cliffanet/sigplane/cable.md

# Ан-28

* Голова-распредблок (5 жил): 230-250 см
* Левый борт (4 жил): 310-330 см
* Правый борт (4 жил): 200-220 см
