cliffanet/sigplane/hw/head/v0.1/sigplane-ctrl-v0.1.png

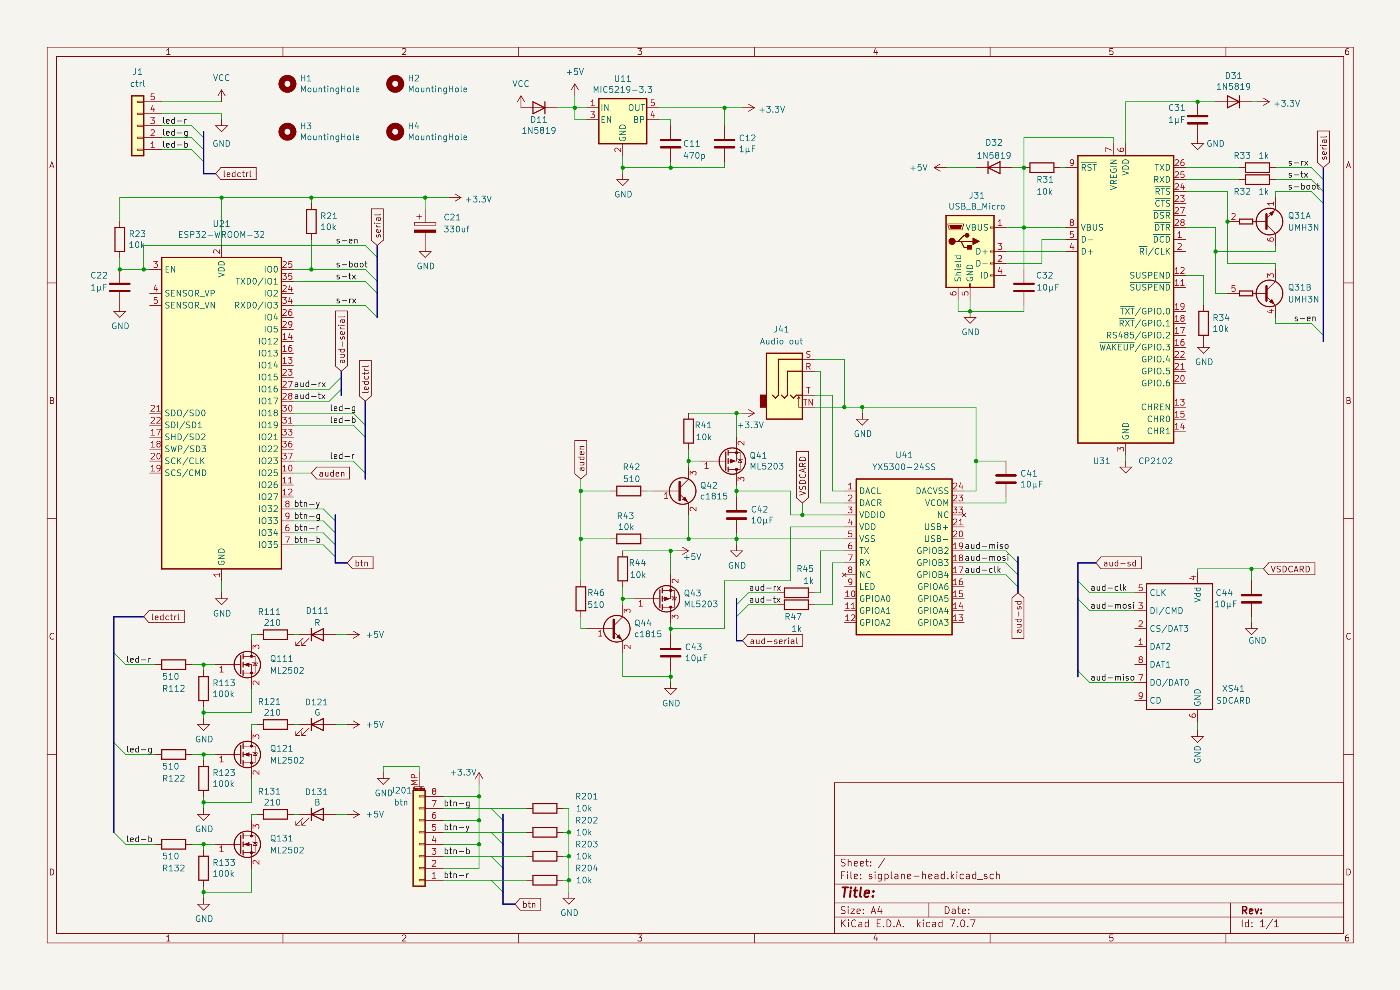
hw/head/v0.1/sigplane-ctrl-v0.1.png
