cliffanet/sigplane/hw/power/v0.1/sigplane-power-v0.1.png

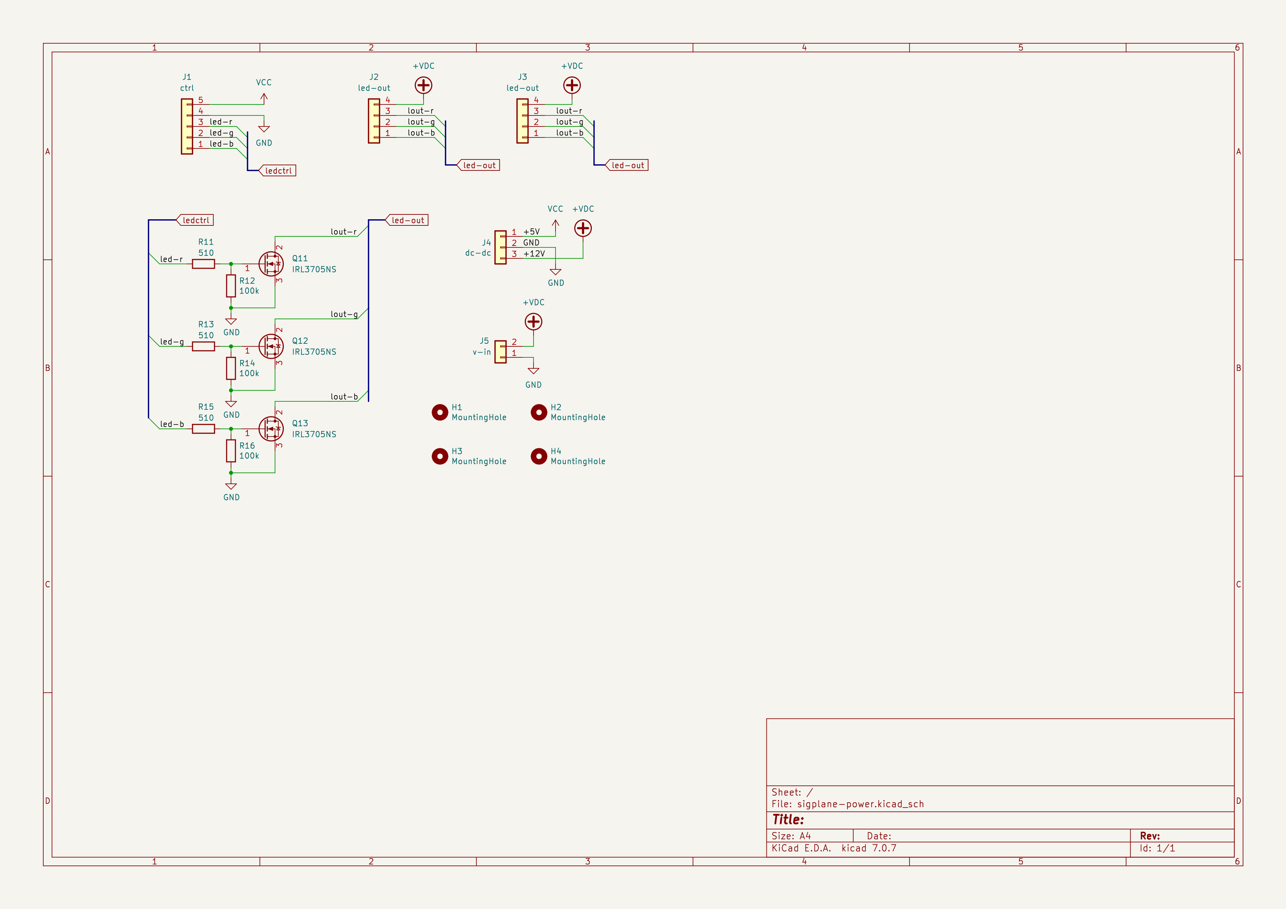
hw/power/v0.1/sigplane-power-v0.1.png
