cliffanet/sigplane/hw/head/sigplane-head.csv

Reference | Qty | Value | DNP | Exclude from BOM | Exclude from Board | Footprint | Datasheet
C11 | 1 | 470p |  |  |  | Capacitor_SMD:C_0805_2012Metric | ~
C12,C22,C31 | 3 | 1μF |  |  |  | Capacitor_SMD:C_0805_2012Metric | ~
C21 | 1 | 330uf |  |  |  | Capacitor_Tantalum_SMD:CP_EIA-7343-20_Kemet-V | ~
C32,C41,C42,C43,C44 | 5 | 10μF |  |  |  | Capacitor_SMD:C_0805_2012Metric | ~
D11,D31,D32 | 3 | 1N5819 |  |  |  | Diode_SMD:D_SOD-323 | ~
D111 | 1 | R |  |  |  | LED_THT:LED_D10.0mm | ~
D121 | 1 | G |  |  |  | LED_THT:LED_D10.0mm | ~
D131 | 1 | B |  |  |  | LED_THT:LED_D10.0mm | ~
H1,H2,H3,H4 | 4 | MountingHole |  |  |  | MountingHole:MountingHole_3.2mm_M3 | ~
J1 | 1 | ctrl |  |  |  | Connector_JST:JST_XH_S5B-XH-A_1x05_P2.50mm_Horizontal | ~
J31 | 1 | USB_B_Micro |  |  |  | Connector_USB:USB_Micro-B_Molex-105017-0001 | ~
J41 | 1 | Audio out |  |  |  | PJ-320B:BOOMELE_PJ-320B | ~
J201 | 1 | btn |  |  |  | Connector_Molex:Molex_PicoBlade_53398-0871_1x08-1MP_P1.25mm_Vertical | ~
Q31 | 1 | UMH3N |  |  |  | Package_TO_SOT_SMD:SOT-363_SC-70-6 | http://rohmfs.rohm.com/en/products/databook/datasheet/discrete/transistor/digital/emh3t2r-e.pdf
Q41,Q43 | 2 | ML5203 |  |  |  | Package_TO_SOT_SMD:SOT-23 | ~
Q42,Q44 | 2 | c1815 |  |  |  | Package_TO_SOT_SMD:SOT-23 | ~
Q111,Q121,Q131 | 3 | ML2502 |  |  |  | Package_TO_SOT_SMD:SOT-23 | ~
R21,R23,R31,R34,R41,R43,R44,R201,R202,R203,R204 | 11 | 10k |  |  |  | Resistor_SMD:R_0805_2012Metric | ~
R32,R33,R45,R47 | 4 | 1k |  |  |  | Resistor_SMD:R_0805_2012Metric | ~
R42,R46,R112,R122,R132 | 5 | 510 |  |  |  | Resistor_SMD:R_0805_2012Metric | ~
R111,R121,R131 | 3 | 210 |  |  |  | Resistor_SMD:R_1206_3216Metric | ~
R113,R123,R133 | 3 | 100k |  |  |  | Resistor_SMD:R_0805_2012Metric | ~
U11 | 1 | MIC5219-3.3 |  |  |  | Package_TO_SOT_SMD:SOT-23-5 | http://ww1.microchip.com/downloads/en/DeviceDoc/MIC5219-500mA-Peak-Output-LDO-Regulator-DS20006021A.pdf
U21 | 1 | ESP32-WROOM-32 |  |  |  | RF_Module:ESP32-WROOM-32 | https://www.espressif.com/sites/default/files/documentation/esp32-wroom-32_datasheet_en.pdf
U31 | 1 | CP2102 |  |  |  | Package_DFN_QFN:QFN-28-1EP_5x5mm_P0.5mm_EP3.35x3.35mm | https://www.silabs.com/documents/public/data-sheets/cp2102n-datasheet.pdf
U41 | 1 | YX5300-24SS |  |  |  | Package_SO:SSOP-24_3.9x8.7mm_P0.635mm | http://www.x-powers.com/en.php/Info/product_detail/article_id/95
XS41 | 1 | SDCARD |  |  |  | microsd:Conn_uSDcard | _
