cliffanet/sigplane/box/sigplane-power.FCStd

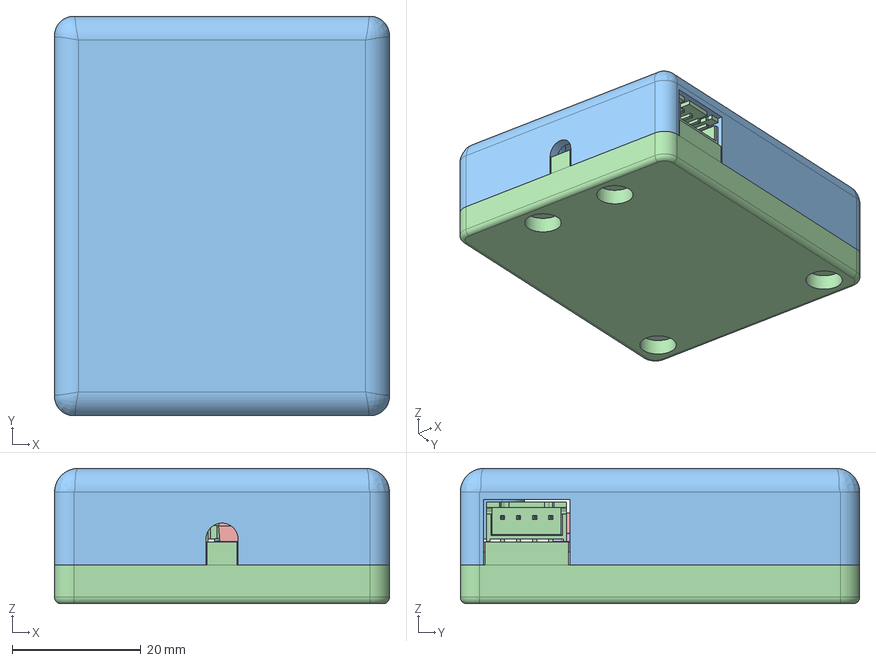
[picture p3: CAD file, 2026-11-03]
box/sigplane-power.FCStd
52.0 x 62.0 x 21.0 mm
sigplane-power PCB
top
bottom
