cliffanet/sigplane/box/sigplane-power-top.stl

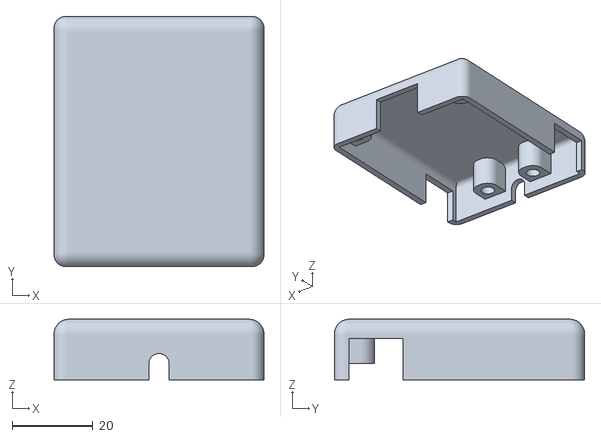
[picture p4: CAD file, 2026-11-03]
box/sigplane-power-top.stl
52.0 x 62.0 x 15.0
