cliffanet/sigplane/box/sigplane-head.FCStd

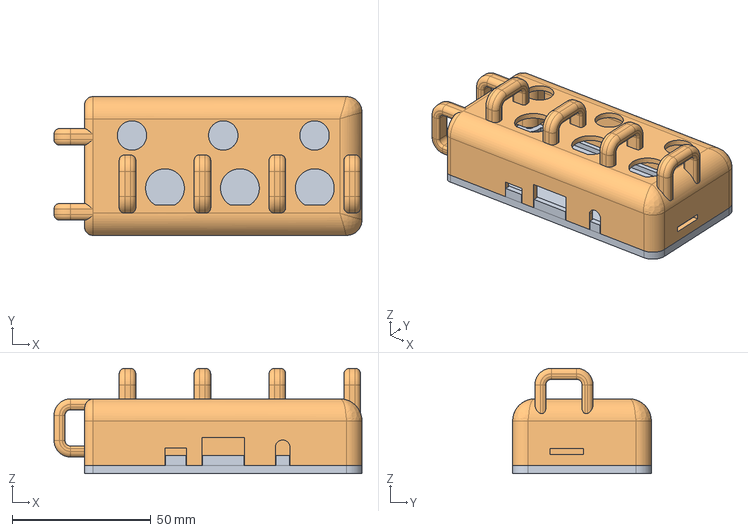
[picture p5: CAD file, 2026-11-03]
box/sigplane-head.FCStd
111.0 x 50.0 x 38.0 mm
bottom
