cliffanet/sigplane/box/sigplane-head-bottom.stl

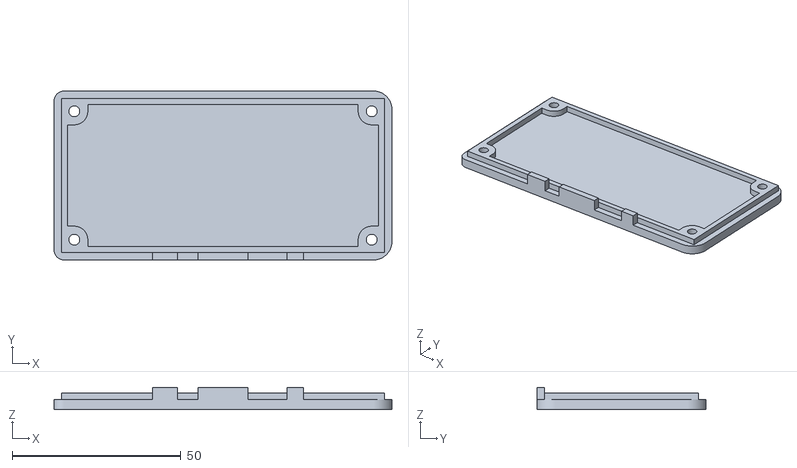
[picture p6: CAD file, 2026-11-03]
box/sigplane-head-bottom.stl
100.0 x 50.0 x 6.60
