cliffanet/sigplane/box/sigplane-head-top.stl

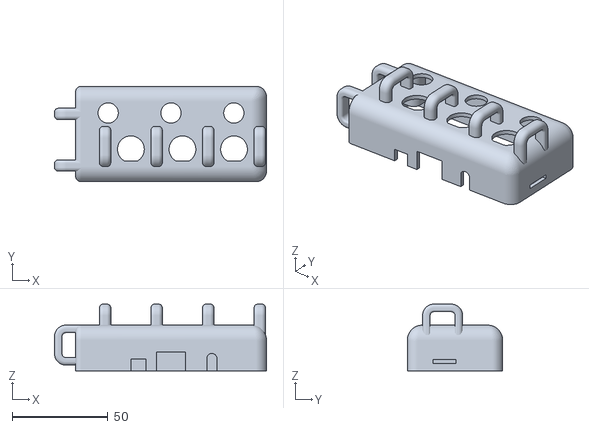
[picture p7: CAD file, 2026-11-03]
box/sigplane-head-top.stl
111.0 x 50.0 x 35.0
