cliffanet/sigplane/box/sigplane-power-bottom.stl

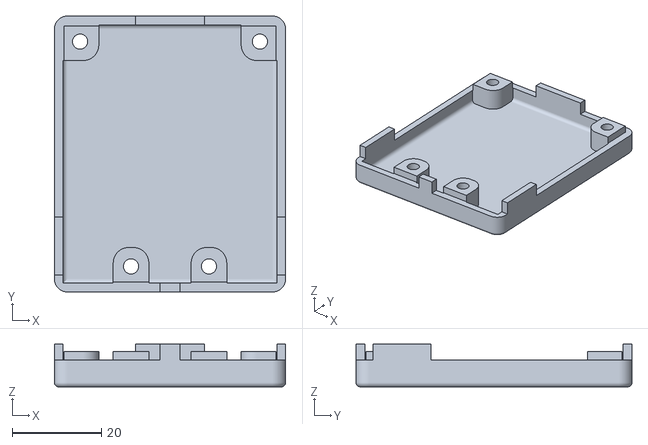
[picture p8: CAD file, 2024-03-09]
box/sigplane-power-bottom.stl
52.0 x 62.0 x 9.60
