cliffanet/sigplane/hw/head/v0.1/sigplane-head.kicad_pcb

## KiCad design hw/head/v0.1/sigplane-head.kicad_pcb (2024-02-26)

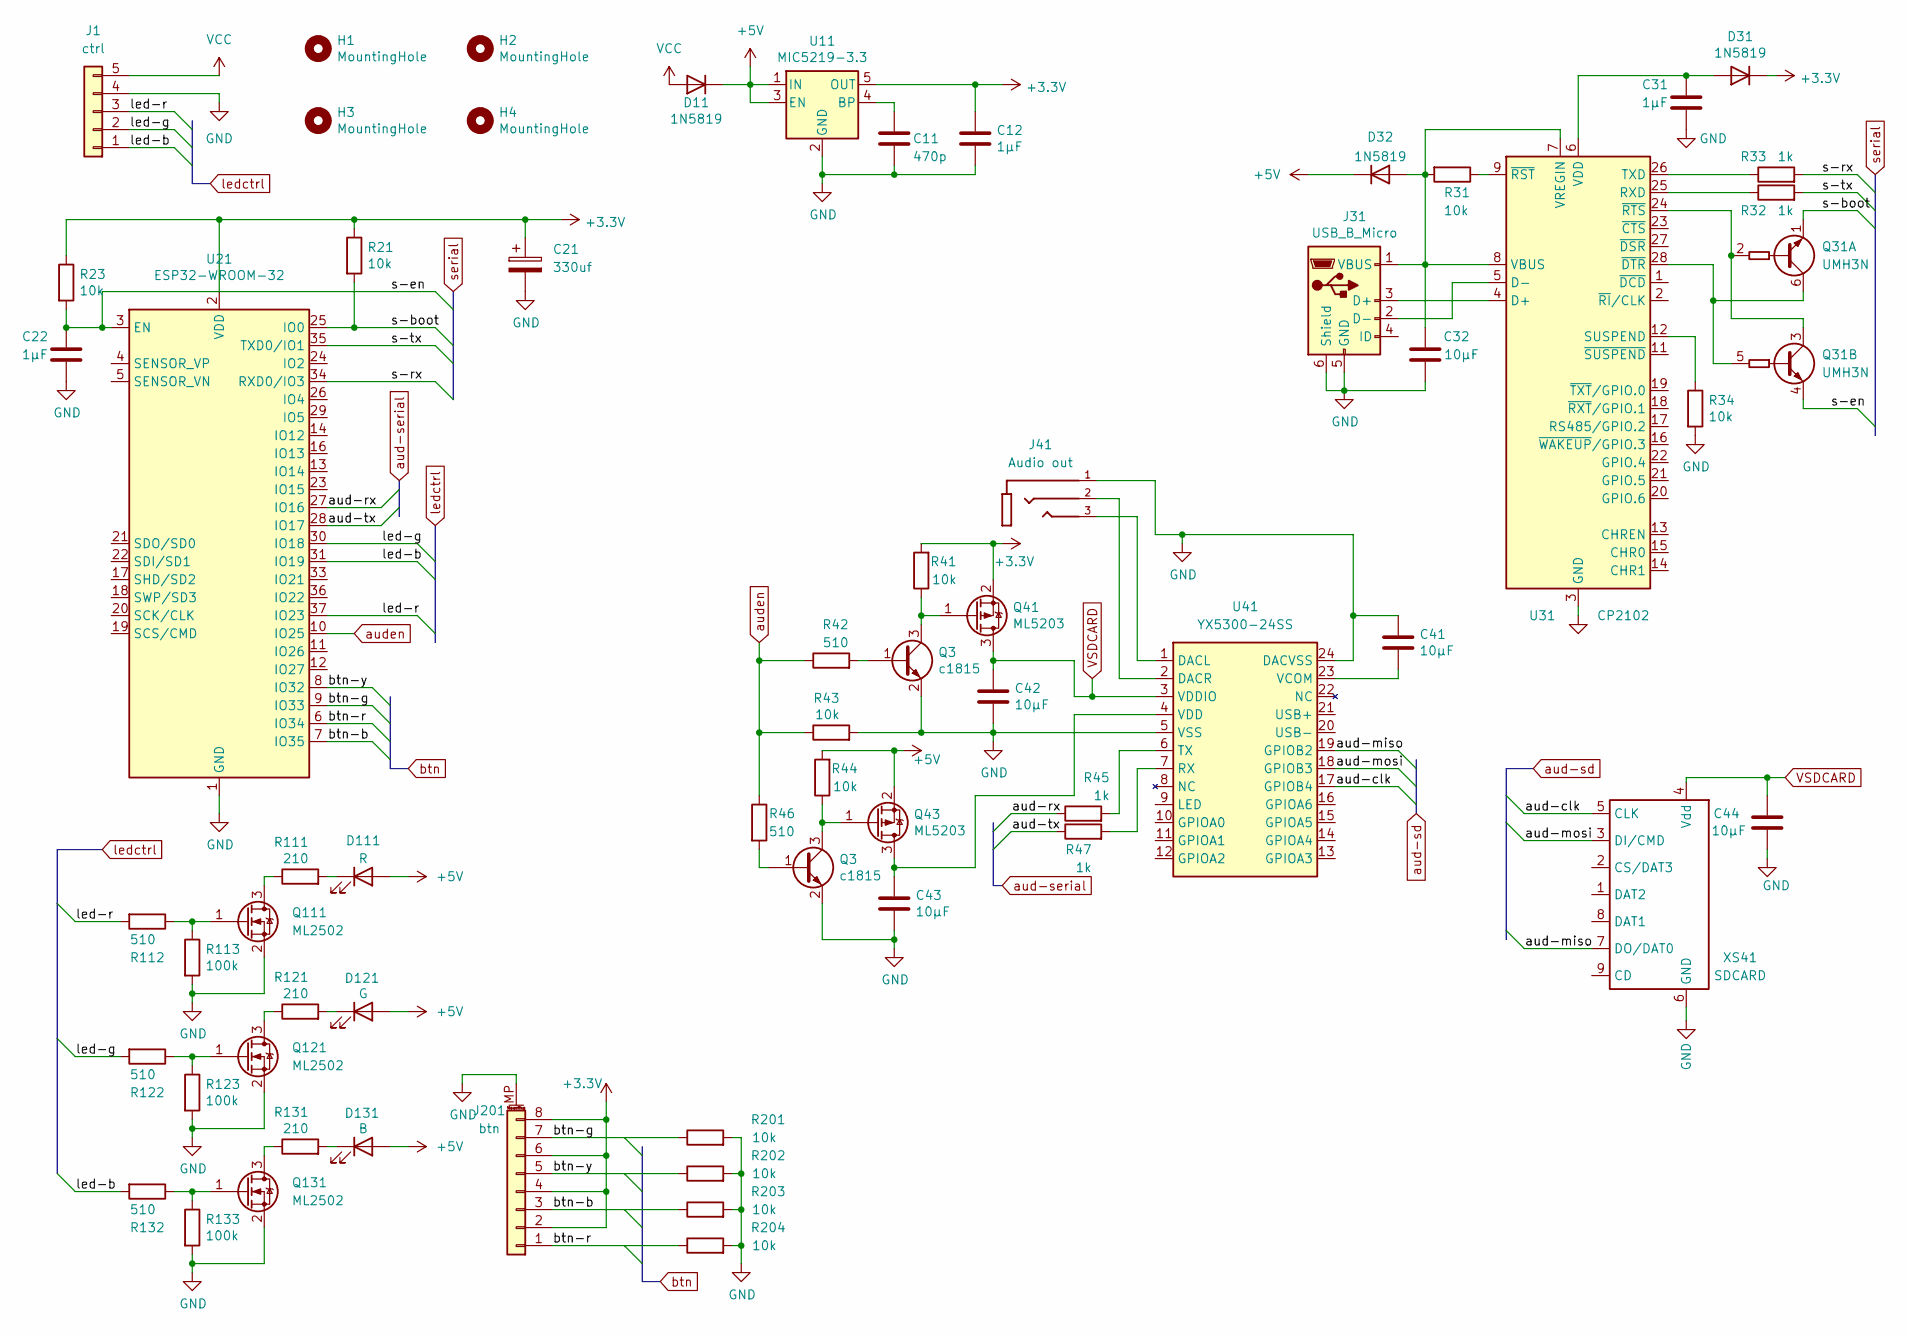
[picture p9: schematic sigplane-head.kicad_sch]

Parts:
C11: 470p; C_0805_2012Metric
C12, C22, C31: 1μF; C_0805_2012Metric
C21: 330uf; CP_EIA-7343-20_Kemet-V
C32, C41, C42, C43, C44: 10μF; C_0805_2012Metric
D11, D31, D32: 1N5819; D_SOD-323
D111: R; LED_D10.0mm
D121: G; LED_D10.0mm
D131: B; LED_D10.0mm
H1, H2, H3, H4: MountingHole; MountingHole_3.2mm_M3
J1: ctrl; JST_XH_S5B-XH-A_1x05_P2.50mm_Horizontal
J31: USB_B_Micro; USB_Micro-B_Molex-105017-0001
J41: Audio out; BOOMELE_PJ-320B
J201: btn; Molex_PicoBlade_53398-0871_1x08-1MP_P1.25mm_Vertical
Q3: c1815; SOT-23
Q31: UMH3N; SOT-363_SC-70-6
Q41, Q43: ML5203; SOT-23
Q111, Q121, Q131: ML2502; SOT-23
R21, R23, R31, R34, R41, R43, R44, R201, R202, R203, R204: 10k; R_0805_2012Metric
R32, R33, R45, R47: 1k; R_0805_2012Metric
R42, R46, R112, R122, R132: 510; R_0805_2012Metric
R111, R121, R131: 210; R_1206_3216Metric
R113, R123, R133: 100k; R_0805_2012Metric
U11: MIC5219-3.3; SOT-23-5
U21: ESP32-WROOM-32
U31: CP2102; QFN-28-1EP_5x5mm_P0.5mm_EP3.35x3.35mm
U41: YX5300-24SS; SSOP-24_3.9x8.7mm_P0.635mm
XS41: SDCARD; Conn_uSDcard

Connections:
+3.3V: C12.1, C21.1, D31.1 (K), J201.2, J201.4, J201.6, J201.8, Q41.2 (S), R21.1, R23.1, R41.2, U11.5 (OUT), U21.2 (VDD)
+5V: D11.1 (K), D32.1 (K), D111.2 (A), D121.2 (A), D131.2 (A), Q43.2 (S), R44.2, U11.1 (IN), U11.3 (EN)
/aud-clk: U41.17 (GPIOB4), XS41.5 (CLK)
/aud-miso: U41.19 (GPIOB2), XS41.7 (DO/DAT0)
/aud-mosi: U41.18 (GPIOB3), XS41.3 (DI/CMD)
/aud-rx: R45.1, U21.27 (IO16)
/aud-tx: R47.1, U21.28 (IO17)
/btn-b: J201.3, R203.1, U21.7 (IO35)
/btn-g: J201.7, R201.1, U21.9 (IO33)
/btn-r: J201.1, R204.1, U21.6 (IO34)
/btn-y: J201.5, R202.1, U21.8 (IO32)
/led-b: J1.1, R132.2, U21.31 (IO19)
/led-g: J1.2, R122.2, U21.30 (IO18)
/led-r: J1.3, R112.2, U21.37 (IO23)
/s-boot: Q31.1 (E1), R21.2, U21.25 (IO0)
/s-en: C22.1, Q31.4 (E2), R23.2, U21.3 (EN)
/s-rx: R33.2, U21.34 (RXD0/IO3)
/s-tx: R32.2, U21.35 (TXD0/IO1)
GND: C11.2, C12.2, C21.2, C22.2, C31.2, C32.1, C41.1, C42.2, C43.2, C44.2, J1.4, J31.5 (GND), J31.6 (Shield), J41.1, J201.MP (MountPin), Q111.2 (S), Q121.2 (S), Q131.2 (S), R34.2, R43.2, R113.2, R123.2, R133.2, R201.2, R202.2, R203.2, R204.2, U11.2 (GND), U21.1 (GND), U21.15 (GND), U21.38 (GND), U21.39 (GND), U31.3 (GND), U31.29 (GND), U41.5 (VSS), U41.24 (DACVSS), XS41.6 (GND); also elsewhere on the board
unnamed: C31.1, D31.2 (A), U31.6 (VDD)
unnamed: C32.2, D32.2 (A), J31.1 (VBUS), R31.2, U31.7 (VREGIN), U31.8 (VBUS)
unnamed: D111.1 (K), R111.2
unnamed: D121.1 (K), R121.2
unnamed: D131.1 (K), R131.2
unnamed: J31.3 (D+), U31.4 (D+)
unnamed: J31.2 (D-), U31.5 (D-)
unnamed: Q31.2 (B1), Q31.3 (C2), U31.24 (~RTS)
unnamed: Q31.5 (B2), Q31.6 (C1), U31.28 (~DTR)
unnamed 28: Q41.1 (G), R41.1; also elsewhere on the board
unnamed 29: R42.2; also elsewhere on the board
unnamed: C43.1, Q43.3 (D), U41.4 (VDD)
unnamed 31: Q43.1 (G), R44.1; also elsewhere on the board
unnamed 32: R46.2; also elsewhere on the board
unnamed: Q111.3 (D), R111.1
unnamed: Q111.1 (G), R112.1, R113.1
unnamed: Q121.3 (D), R121.1
unnamed: Q121.1 (G), R122.1, R123.1
unnamed: Q131.3 (D), R131.1
unnamed: Q131.1 (G), R132.1, R133.1
unnamed: C11.1, U11.4 (BP)
unnamed: R32.1, U31.25 (RXD)
unnamed: R34.1, U31.12 (SUSPEND)
unnamed: R33.1, U31.26 (TXD)
unnamed: R31.1, U31.9 (~RST)
unnamed: J41.3, U41.1 (DACL)
unnamed: J41.2, U41.2 (DACR)
unnamed: R47.2, U41.7 (RX)
unnamed: R45.2, U41.6 (TX)
unnamed: C41.2, U41.23 (VCOM)
VCC: D11.2 (A), J1.5
VSDCARD: C42.1, C44.1, Q41.3 (D), U41.3 (VDDIO), XS41.4 (Vdd)
auden: R42.1, R43.1, R46.1, U21.10 (IO25)

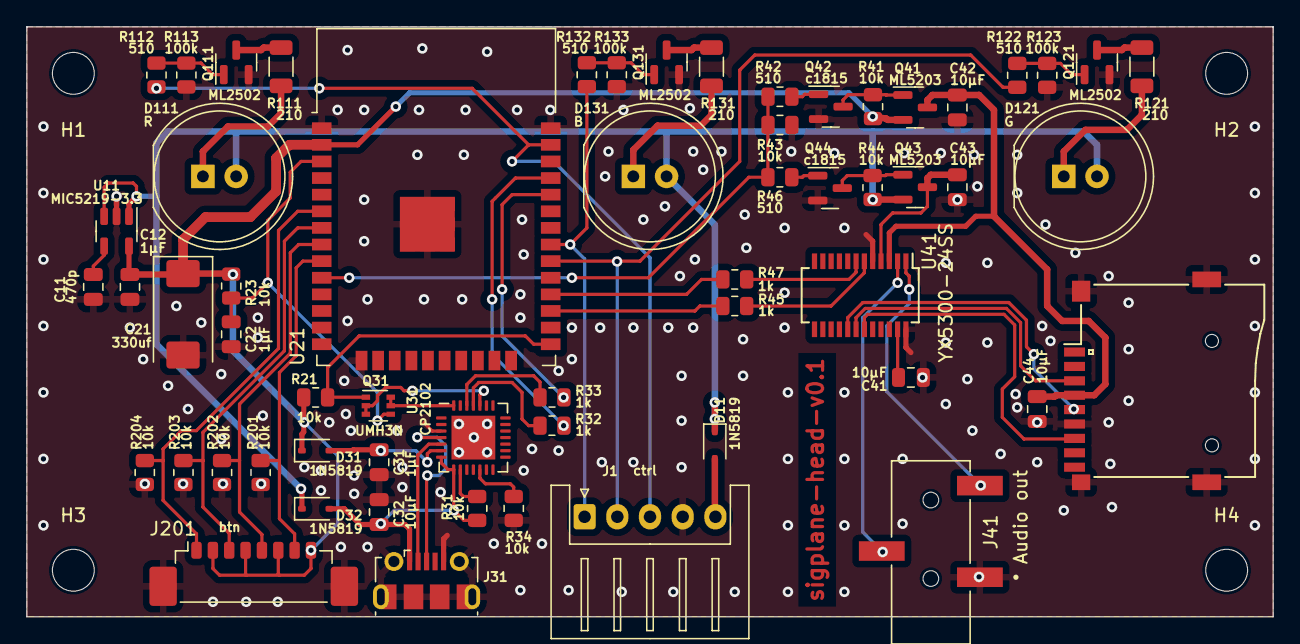
[picture p10: board sigplane-head.kicad_pcb from above]

Board: 2 copper layers, 95.2 x 45.1 mm, 63 parts (0 on the bottom side), 52 nets.

Other parts of the board:
Q42, Q44: c1815; SOT-23

Their connections:
GND: Q42.2 (E), Q44.2 (E); also elsewhere on the board
unnamed 28: Q42.3 (C); also elsewhere on the board
unnamed 29: Q42.1 (B); also elsewhere on the board
unnamed 31: Q44.3 (C); also elsewhere on the board
unnamed 32: Q44.1 (B); also elsewhere on the board
