cliffanet/sigplane/hw/power/v0.1/sigplane-power.kicad_pcb

## KiCad design hw/power/v0.1/sigplane-power.kicad_pcb (2023-11-05)

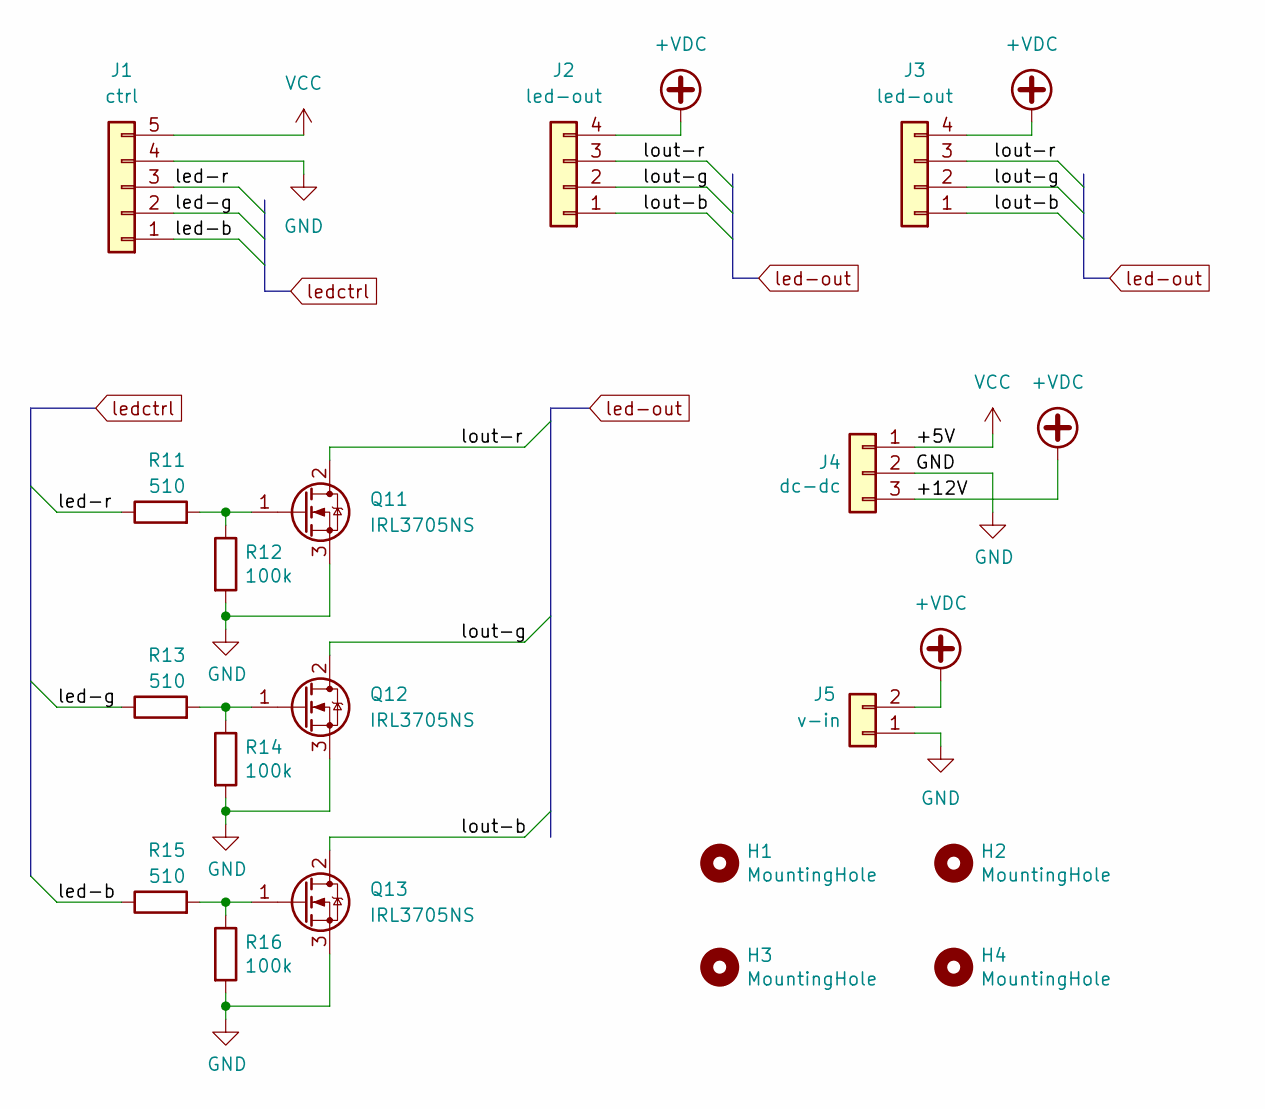
[picture p11: schematic sigplane-power.kicad_sch]

Parts:
H1, H2, H3, H4: MountingHole; MountingHole_3.2mm_M3
J1: ctrl; JST_XH_S5B-XH-A_1x05_P2.50mm_Horizontal
J2, J3: led-out; JST_XH_S4B-XH-A_1x04_P2.50mm_Horizontal
J4: dc-dc; PinHeader_1x03_P2.54mm_Vertical
J5: v-in; SolderWire-0.75sqmm_1x02_P4.8mm_D1.25mm_OD2.3mm
Q11, Q12, Q13: IRL3705NS; TO-263-2
R11, R13, R15: 510; R_0805_2012Metric
R12, R14, R16: 100k; R_0805_2012Metric

Connections:
+VDC: J2.4, J3.4, J4.3, J5.2
/led-b: J1.1, R15.1
/led-g: J1.2, R13.1
/led-r: J1.3, R11.1
/lout-b: J2.1, J3.1, Q13.2 (D)
/lout-g: J2.2, J3.2, Q12.2 (D)
/lout-r: J2.3, J3.3, Q11.2 (D)
GND: J1.4, J4.2, J5.1, Q11.3 (S), Q12.3 (S), Q13.3 (S), R12.2, R14.2, R16.2
unnamed: Q11.1 (G), R11.2, R12.1
unnamed: Q12.1 (G), R13.2, R14.1
unnamed: Q13.1 (G), R15.2, R16.1
VCC: J1.5, J4.1

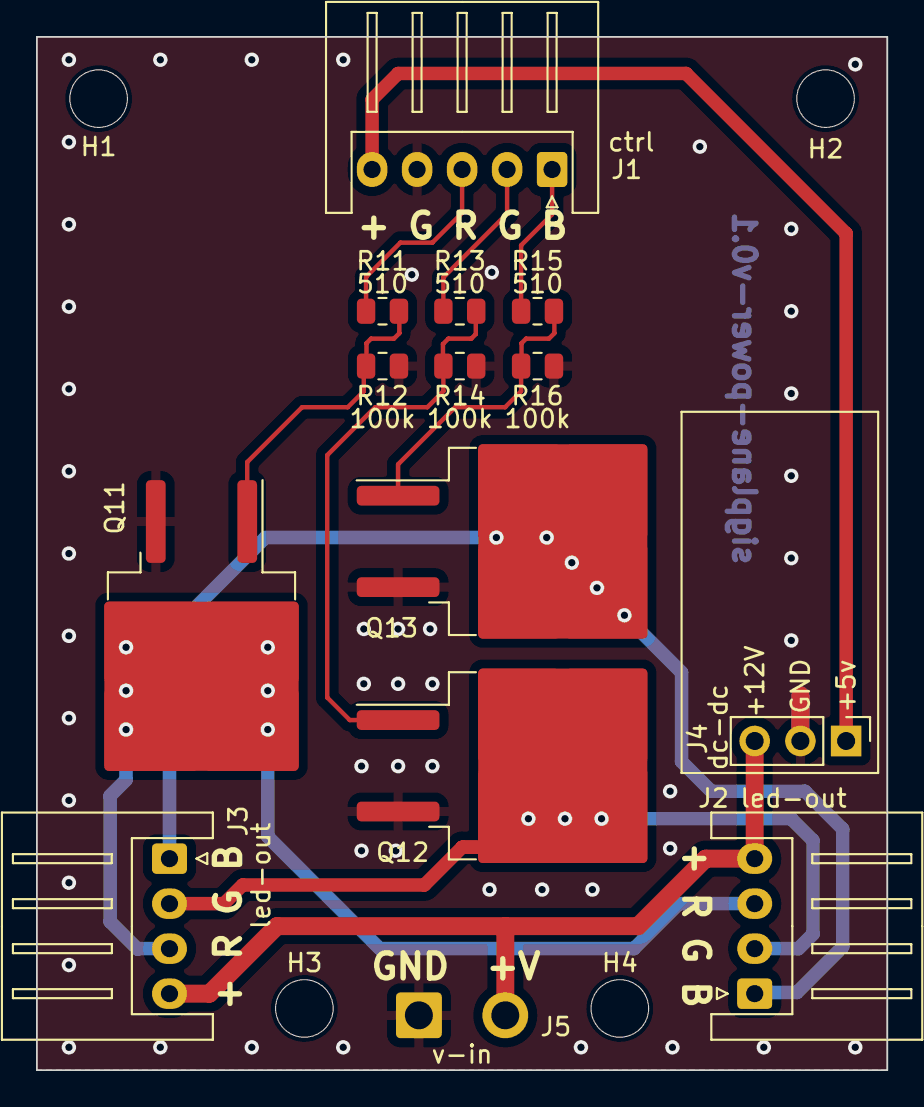
[picture p12: board sigplane-power.kicad_pcb from above]

Board: 2 copper layers, 47.2 x 57.4 mm, 18 parts (0 on the bottom side), 12 nets.
