cliffanet/sigplane/verifone.md

# CP2102 - Проблемы с прошивкой

Устройство при подключении к USB определяется как "Verifone USB to Printer".

Проблема с прошивкой самого чипа CP2102.

## Инструкция по исправлению

1. В MacOS:

    ```
    system_profiler SPUSBDataType
    ```

    или

    ```
    ioreg -p IOUSB
    ```

    Ищем `Product ID` и `Vendor ID`.

2. На сайте https://www.silabs.com/support ищем:

    ```
    install_USBXpress_SDK.exe
    ```

    Устанавливаем.

3. USBXpress Driver: Подставляем PID и VID, генерируем драйвер, либо используем стандартный универсальный драйвер.

Для Win10 - отключение проверки подписи драйвера:

1. Откройте Параметры (Win + I) -> Обновление и безопасность -> Восстановление.
2. В разделе «Особые варианты загрузки» нажмите кнопку «Перезагрузить сейчас».
3. После перезапуска синего экрана выберите: Поиск и устранение неисправностей -> Дополнительные параметры -> Параметры загрузки -> нажмите Перезагрузить.
4. Когда появится список вариантов, нажмите клавишу 7 или F7 («Отключить принудительную проверку подписи драйверов»).
5. Windows загрузится в обычном режиме, но без проверки подписи. Установите ваш драйвер (если появится системное предупреждение, выберите «Все равно установить этот драйвер»).

4. Там же https://www.silabs.com/support:

    ```
    CP21xxCustomizationUtility
    ```
    
    либо: USBXpress Device Customization Utility (из п.2)

    Должно появиться устройство. Если устройство не видно, надо сгенерировать драйвер ещё раз.

5. Меняем:
    
    ```
    Vendor ID: 0x10c4  (Silicon Laboratories, Inc.)
    Product ID: 0xea60
    Power: 32
    Power Mode: 00 - Bus powered
    Realese Version: 0100
    Product Description: CP2102 USB to UART Bridge Controller
    Serial: 0001
    Lock Device: 00 - Device is unlocked
    ```

6. Жмём `Program Device`
