cliffanet/sigplane/(commit log)

2023-09-25 таймаут на все сигналы
2023-10-07 платы - head только схема (требуется доработка), power - полностью с разводкой
    [sigplane-head.kicad_sch, sigplane-power.kicad_pcb, sigplane-power.kicad_sch]
2023-10-28 hw power - изменён корпус транзистора
    [sigplane-power.kicad_pcb, sigplane-power.kicad_sch]
2023-10-29 hw head - элементы размещены на плате, но не соединены
    [sigplane-head.kicad_pcb, sigplane-head.kicad_sch]
2023-10-29 hw head - плата разведена
    [sigplane-head.kicad_pcb, sigplane-head.kicad_sch]
2023-11-05 hw - гербер
    [sigplane-head.kicad_pcb, sigplane-power.kicad_pcb, sigplane-power.kicad_sch]
2024-02-25 hw плата - поправлены косяки mp3-части
    [sigplane-head.kicad_pcb, sigplane-head.kicad_sch, sigplane-power.kicad_pcb, sigplane-power.kicad_sch]
2024-02-25 воспроизведение mp3
2024-02-26 hw плата - небольшие доработки
    [sigplane-head.kicad_pcb]
2024-03-09 корпус обоих блоков
    [sigplane-head-bottom.stl, sigplane-head-top.stl, sigplane-head.FCStd, sigplane-power-bottom.stl, sigplane-power-top.stl, sigplane-power.FCStd]
2024-03-09 удаляем старый пробный корпус
    [sigplane-main-box.stl, sigplane-main-cap.stl, sigplane-main.skp]
2024-05-20 переработан алгоритм работы с кнопками
2024-06-02 уменьшено время ожидания до 2 мин
2026-11-03 небольшая доработка корпуса головы (отверстия кнопок и под бонки)
2026-11-03 ещё доработана verifone-инструкция и доработан силовой корпус под бонки
2026-11-05 cncpaste - gcode для нанесения пасты на плату
